JacksonYowe/tower-designer/examples/reference-tower/picture_jig.png

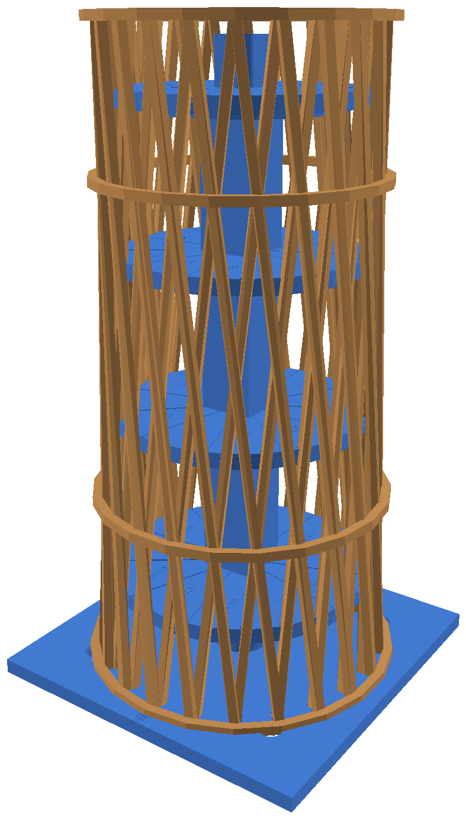
examples/reference-tower/picture_jig.png
