JacksonYowe/tower-designer/test-kits/Glue test kit/glue_test_jig_comb.step

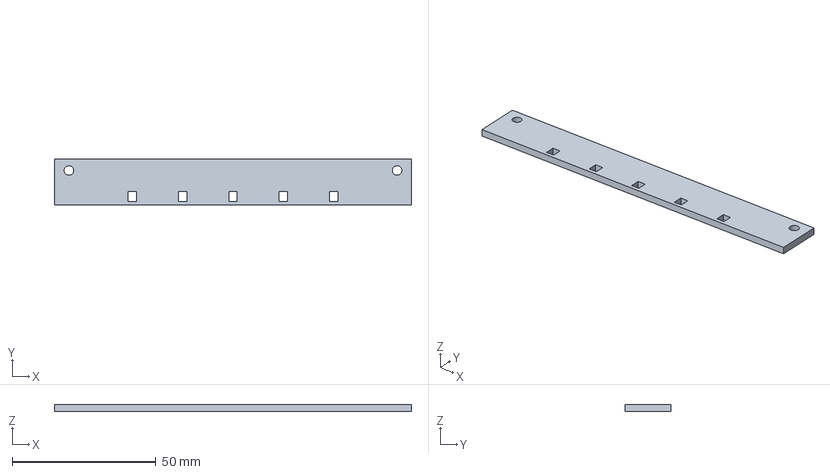
[picture p3: CAD file, 2026-10-26]
test-kits/Glue test kit/glue_test_jig_comb.step
124.0 x 16.0 x 2.40 mm
