JacksonYowe/tower-designer/test-kits/Wood test kit/wood_test_squaring_block.step

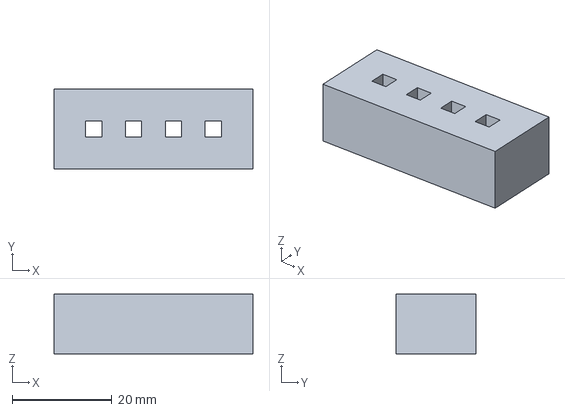
[picture p4: CAD file, 2026-10-26]
test-kits/Wood test kit/wood_test_squaring_block.step
40.0 x 16.0 x 12.0 mm
