JacksonYowe/tower-designer/test-kits/Glue test kit/glue_test_jig_base.step

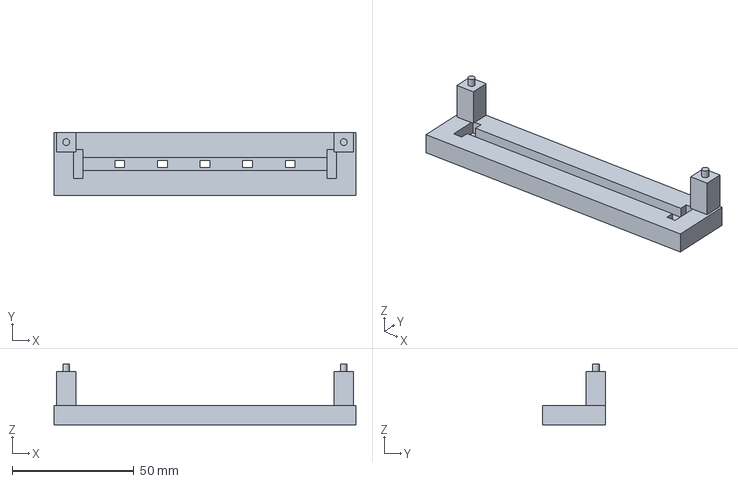
[picture p5: CAD file, 2026-10-26]
test-kits/Glue test kit/glue_test_jig_base.step
124.0 x 26.0 x 25.0 mm
