JacksonYowe/tower-designer/test-kits/Wood test kit/wood_test_crush_pad.step

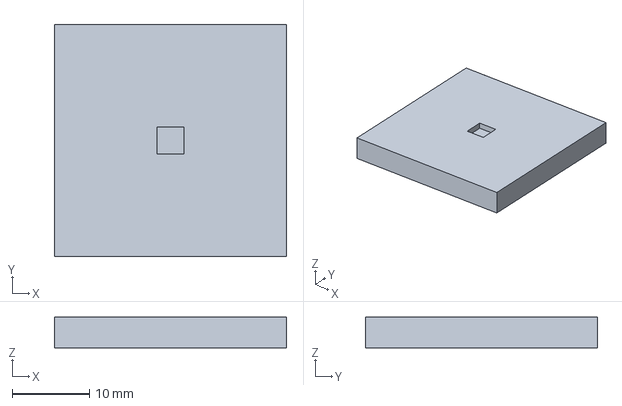
[picture p6: CAD file, 2026-10-26]
test-kits/Wood test kit/wood_test_crush_pad.step
30.0 x 30.0 x 4.00 mm
