JacksonYowe/tower-designer/test-kits/Wood test kit/wood_test_buckling_cap.step

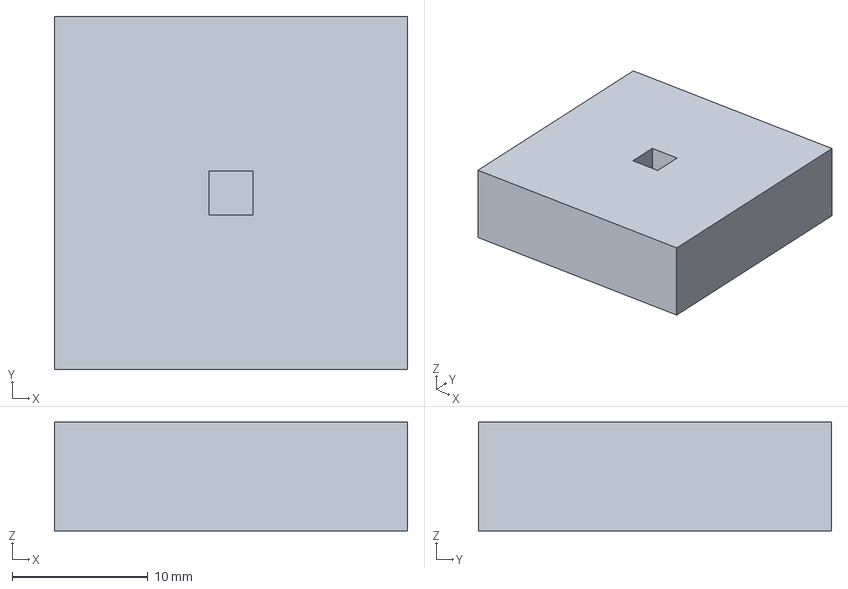
[picture p7: CAD file, 2026-10-26]
test-kits/Wood test kit/wood_test_buckling_cap.step
26.0 x 26.0 x 8.00 mm
