JacksonYowe/tower-designer/test-kits/Wood test kit/wood_test_150mm_cut_guide.step

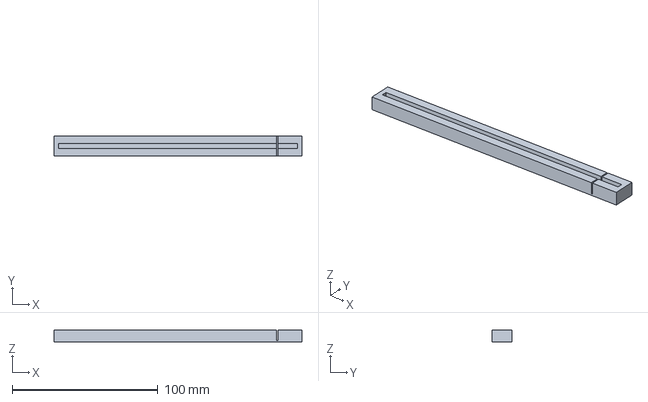
[picture p8: CAD file, 2026-10-26]
test-kits/Wood test kit/wood_test_150mm_cut_guide.step
170.0 x 14.0 x 8.00 mm
