JacksonYowe/tower-designer/(list of files, cad)

Other CAD files:
test-kits/Glue test kit/glue_test_strips_1.dxf
test-kits/Glue test kit/glue_test_jig_base.stl
test-kits/Glue test kit/glue_test_jig_comb.stl
test-kits/Wood test kit/wood_test_150mm_cut_guide.stl
test-kits/Wood test kit/wood_test_buckling_cap.stl
test-kits/Wood test kit/wood_test_crush_pad.stl
test-kits/Wood test kit/wood_test_squaring_block.stl
