JacksonYowe/tower-designer/(commit log)

2026-10-26 Tower Designer: timber tower design, analysis and jig generator for macOS
    Includes the reference 3x3 diagrid tower, wood and glue test kits,
    and a PyInstaller build script. Licensed under GPLv3.
    [glue_test_jig_base.step, glue_test_jig_base.stl, glue_test_jig_comb.step, glue_test_jig_comb.stl, glue_test_strips_1.dxf, wood_test_150mm_cut_guide.step, wood_test_150mm_cut_guide.stl, wood_test_buckling_cap.step]
2026-10-27 Fix ring model, add tolerances and fit check, revise reference tower
    - Rings are drawn and sized where they really sit (outside the B strips);
    ring pieces were about 2 mm short.
    - Remove the 1-in-3 scarf ring joint: with full-size sticks a flat scarf
    can't close at a ring corner. Add a shingled-lap option; half-lap ends
    are now modelled cut along the strip so neighbours meet flush.
    - New tolerances module: a tolerance table and per-cut tolerances in the
    guide, with matching jig allowances (strip sanding allowance on the
    cutting guide, length ticks on the marking gauge).
    - Automatic fit check on every export (crossings, ring ends, ring joints,
    jig clearance), printed in the guide.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
2026-10-27 Model strips as they really sit; real fit check; revise reference tower
    - Straight strips on a hyperboloid must twist to lie flat: the 3D model
    now twists each strip to the surface, and collar notches follow it.
    Rings are tilted to the surface and seated on the outer strips.
    - Strength model now matches the build: inner and outer strips are glued
    at every foot and top (half the patch, because of the level cut), and
    lapped rings are glued to the outer strips.
    - Fit check measures contact area within 0.2 mm when pressed, the face
    angle at crossings and the gap a peg must close, instead of only the
    closest point.
    - Guide: twist, damping and pegging instructions; strip tolerance ±0.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
2026-10-27 Foolproof cutting jigs and assembly guide
    - Separate cutting guides: CG1 for strips, CG2 for ring pieces. Every
    channel has a tall saw guide over its slot (keeps the saw square and
    holds the stick down) and is engraved with piece name, length and count.
    - Stops allow for the saw kerf (saw on the slot's left, waste-side face).
    - Ring pieces with near-parallel ends (within 2 deg) are cut against a
    stop too: no waste stub, and only the outer face needs marking.
    - Guide: a 'read this first' page of 10 rules, the whole build at a
    glance, a 'you need' box (pieces, jig, glue, time, wait) and a 'glue is
    hard to undo' warning on every gluing step, and a picture of where the
    saw goes.
    Co-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
